anildash/dashtouch/helper/tests/test_webui.py

import http.client
import json
import pathlib
import threading
import time
import urllib.error
from types import SimpleNamespace
from unittest import mock

from dashtouch_helper import webui


CANNED_HEALTH = [
    {"id": "device", "label": "Device", "ok": True, "state": "ok",
     "detail": "Connected — firmware dt-0.1.0", "fix": "help-not-connected"},
    {"id": "password", "label": "Password", "ok": False, "state": "bad",
     "detail": "Not set up yet", "fix": "help-password"},
]


class FakeDaemon:
    def __init__(self):
        self.state = {"connected": True, "sensor": "ok", "fw": "dt-0.1.0",
                      "enroll_stage": "", "last_line": "", "cap": "200",
                      "slots_used": [1, 3], "last_match": None}
        self.sent = []
        self.events = []
        self._events_lock = threading.Lock()

    def send_command(self, line):
        self.sent.append(line)

    def log_event(self, direction, text):
        self.events.append({"t": time.time(), "dir": direction, "text": text})

    def health(self):
        return CANNED_HEALTH


def start():
    d = FakeDaemon()
    url = webui.start(d, port=0)  # 0 = ephemeral port for tests
    host, port = url.split("//")[1].split("/")[0].split(":")
    token = url.split("token=")[1]
    return d, host, int(port), token


def req(host, port, method, path, body=None, token=None):
    c = http.client.HTTPConnection(host, port, timeout=3)
    headers = {"Content-Type": "application/json"}
    if token:
        headers["X-DT-Token"] = token
    c.request(method, path, json.dumps(body) if body else None, headers)
    r = c.getresponse()
    return r.status, json.loads(r.read() or b"{}")


def test_status_needs_no_token():
    d, host, port, token = start()
    status, body = req(host, port, "GET", "/api/status")
    assert status == 200 and body["connected"] is True


def test_status_carries_slots_used():
    d, host, port, token = start()
    status, body = req(host, port, "GET", "/api/status")
    assert status == 200
    assert body["slots_used"] == [1, 3]


def test_status_carries_health_rows():
    d, host, port, token = start()
    status, body = req(host, port, "GET", "/api/status")
    assert status == 200
    assert body["health"] == CANNED_HEALTH


def test_enroll_without_token_rejected():
    d, host, port, token = start()
    status, _ = req(host, port, "POST", "/api/enroll", {"slot": 1, "label": "x"})
    assert status == 403
    assert d.sent == []


def test_enroll_with_token_sends_command_and_saves_label(tmp_path, monkeypatch):
    monkeypatch.setattr(webui, "LABELS_PATH", tmp_path / "labels.json")
    d, host, port, token = start()
    status, _ = req(host, port, "POST", "/api/enroll",
                    {"slot": 2, "label": "right index"}, token)
    assert status == 202
    assert d.sent == ["ENROLL 2"]
    # Label is stored in pending_label, not written yet
    assert d.pending_label == {"slot": 2, "label": "right index"}
    # Labels file should not exist
    assert not (tmp_path / "labels.json").exists()


def test_delete_with_token(tmp_path, monkeypatch):
    monkeypatch.setattr(webui, "LABELS_PATH", tmp_path / "labels.json")
    d, host, port, token = start()
    req(host, port, "POST", "/api/enroll", {"slot": 2, "label": "x"}, token)
    status, _ = req(host, port, "POST", "/api/delete", {"slot": 2}, token)
    assert status == 202
    assert d.sent == ["ENROLL 2", "DELETE 2"]


def test_malformed_body_returns_400():
    d, host, port, token = start()
    c = http.client.HTTPConnection(host, port, timeout=3)
    c.request("POST", "/api/enroll", "not json{{{", {"Content-Type": "application/json", "X-DT-Token": token})
    assert c.getresponse().status == 400
    assert d.sent == []


def test_non_object_json_body_returns_400():
    d, host, port, token = start()
    c = http.client.HTTPConnection(host, port, timeout=3)
    c.request("POST", "/api/enroll", "[1,2,3]", {"Content-Type": "application/json", "X-DT-Token": token})
    assert c.getresponse().status == 400
    assert d.sent == []


def test_start_persists_tokened_url(tmp_path, monkeypatch):
    monkeypatch.setattr(webui, "URL_PATH", tmp_path / "webui-url")
    d = FakeDaemon()
    url = webui.start(d, port=0)
    # Persisted link should be token-less (so it can't be leaked via the
    # filesystem), while the returned URL includes the session token.
    assert (tmp_path / "webui-url").read_text().strip() == url.split("?")[0]
    assert "token=" in url


def test_start_never_adopts_a_stored_token(tmp_path, monkeypatch):
    # The helper used to reuse any stored token of 16+ characters. That's how
    # a test fixture string, written into a real Keychain by an earlier
    # mocking gap, ended up being served as a live session token. Whatever is
    # in storage, a new run mints its own and overwrites it.
    monkeypatch.setattr(webui, "TOKEN_PATH", tmp_path / "token")
    from dashtouch_helper import keychain

    stale = "x" * 40
    keychain.set_session_token(stale)

    d = FakeDaemon()
    url = webui.start(d, port=0)
    token = url.split("token=")[1]

    assert token != stale
    assert len(token) >= 16
    # ...and the stale value is gone from storage, not just unused.
    assert keychain.get_session_token() == token


def test_start_persists_a_freshly_generated_token(tmp_path, monkeypatch):
    # Token persistence is Keychain-backed in production; tests use the fake
    # keychain that reads/writes webui.TOKEN_PATH. Asserting only that the
    # URL carries *a* token is not enough: a duplicated
    # `token_freshly_generated = token is None` block once left that always
    # False, so the token was never written to the Keychain at all and
    # `dashtouch pins` (which reads it back) broke, with the suite still green.
    monkeypatch.setattr(webui, "TOKEN_PATH", tmp_path / "token")
    from dashtouch_helper import keychain

    d = FakeDaemon()
    url = webui.start(d, port=0)
    token_content = url.split("token=")[1]
    assert len(token_content) >= 16
    assert keychain.get_session_token() == token_content


def test_start_with_token_path_as_directory(tmp_path, monkeypatch):
    monkeypatch.setattr(webui, "TOKEN_PATH", tmp_path / "token")
    # Create a directory where the token file should be
    (tmp_path / "token").mkdir()
    d = FakeDaemon()
    url = webui.start(d, port=0)
    # Should still work with an in-memory token despite the directory in the way
    assert "token=" in url


def test_start_with_invalid_utf8_token(tmp_path, monkeypatch):
    monkeypatch.setattr(webui, "TOKEN_PATH", tmp_path / "token")
    # Write invalid UTF-8 bytes to the token file
    (tmp_path / "token").write_bytes(b"\xff\xfe")
    d = FakeDaemon()
    url = webui.start(d, port=0)
    # The returned URL contains the one-time token used for this run.
    assert "token=" in url
    token_content = url.split("token=")[1]
    assert len(token_content) >= 16


def test_enroll_with_null_slot_returns_400():
    d, host, port, token = start()
    status, _ = req(host, port, "POST", "/api/enroll", {"slot": None, "label": "x"}, token)
    assert status == 400
    assert d.sent == []


def test_log_requires_token_then_returns_events():
    d, host, port, token = start()
    status, _ = req(host, port, "GET", "/api/log")
    assert status == 403
    d.log_event("device", "hello")
    status, body = req(host, port, "GET", "/api/log", token=token)
    assert status == 200
    assert any(e["text"] == "hello" for e in body["events"])


def test_rejected_post_appends_web_event():
    d, host, port, token = start()
    req(host, port, "POST", "/api/enroll", {"slot": 1, "label": "x"})  # no token
    status, body = req(host, port, "GET", "/api/log", token=token)
    assert status == 200
    assert any(e["text"] == "rejected: bad token" for e in body["events"])


def test_default_port_is_3274():
    """When no port argument is given, default is 3274 (or fallback if busy)."""
    d = FakeDaemon()
    url = webui.start(d)  # no port argument = use default
    # Extract port from URL
    actual_port = int(url.split(":")[2].split("/")[0])
    # Port should be 3274 unless it was busy (check daemon log for fallback message)
    if actual_port == 3274:
        # Normal case: port 3274 was available
        assert True
    else:
        # Fallback case: port 3274 was busy, check that we logged it
        assert any("was busy" in e.get("text", "") for e in d.events)


def test_dashtouch_port_env_override_ephemeral():
    """DASHTOUCH_PORT=0 env variable overrides default and uses ephemeral binding."""
    d = FakeDaemon()
    import os
    # Temporarily set env var
    old_val = os.environ.get("DASHTOUCH_PORT")
    try:
        os.environ["DASHTOUCH_PORT"] = "0"
        url = webui.start(d)  # no port argument, but env override = 0 (ephemeral)
        # Extract port from URL
        actual_port = int(url.split(":")[2].split("/")[0])
        # Should be ephemeral (non-zero, assigned by OS)
        assert actual_port > 0, "Ephemeral binding should assign a port > 0"
        assert actual_port != 3274, "With DASHTOUCH_PORT=0, should not use default port"
    finally:
        if old_val is None:
            os.environ.pop("DASHTOUCH_PORT", None)
        else:
            os.environ["DASHTOUCH_PORT"] = old_val


def test_api_status_carries_last_match():
    """Verify that /api/status includes last_match from daemon state."""
    d = FakeDaemon()
    d.state["last_match"] = {"slot": 5, "score": 150}
    host, port, token = start.__wrapped__(d, None, None) if hasattr(start, '__wrapped__') else (None, None, None)
    # Need to get host/port from actual start; use simpler approach
    url = webui.start(d, port=0)
    host, port = url.split("//")[1].split("/")[0].split(":")
    host = host.strip()
    port = int(port)
    token = url.split("token=")[1]

    status, body = req(host, port, "GET", "/api/status")
    assert status == 200
    assert body["last_match"] == {"slot": 5, "score": 150}


def test_enroll_stores_pending_label_not_labels_file(tmp_path, monkeypatch):
    """Enroll request stores pending_label but doesn't write labels.json."""
    from dashtouch_helper import webui
    monkeypatch.setattr(webui, "LABELS_PATH", tmp_path / "labels.json")
    d = FakeDaemon()
    url = webui.start(d, port=0)
    host, port = url.split("//")[1].split("/")[0].split(":")
    token = url.split("token=")[1]
    port = int(port)

    # Enroll a finger
    status, body = req(host, port, "POST", "/api/enroll",
                       {"slot": 5, "label": "right index"}, token=token)
    assert status == 202

    # Labels file should not exist yet
    assert not (tmp_path / "labels.json").exists()
    # Daemon should have pending_label
    assert d.pending_label == {"slot": 5, "label": "right index"}


def test_api_label_requires_token(tmp_path, monkeypatch):
    """POST /api/label without token returns 403."""
    from dashtouch_helper import webui
    monkeypatch.setattr(webui, "LABELS_PATH", tmp_path / "labels.json")
    d = FakeDaemon()
    url = webui.start(d, port=0)
    host, port = url.split("//")[1].split("/")[0].split(":")
    token = url.split("token=")[1]
    port = int(port)

    status, body = req(host, port, "POST", "/api/label",
                       {"slot": 3, "label": "middle"}, token=None)
    assert status == 403


def test_api_label_updates_labels(tmp_path, monkeypatch):
    """POST /api/label with token updates labels.json."""
    from dashtouch_helper import webui
    monkeypatch.setattr(webui, "LABELS_PATH", tmp_path / "labels.json")
    d = FakeDaemon()
    url = webui.start(d, port=0)
    host, port = url.split("//")[1].split("/")[0].split(":")
    token = url.split("token=")[1]
    port = int(port)

    status, body = req(host, port, "POST", "/api/label",
                       {"slot": 3, "label": "middle"}, token=token)
    assert status == 202

    # Check that label was written in object form with a fresh timestamp
    labels = json.loads((tmp_path / "labels.json").read_text())
    assert labels["3"]["label"] == "middle"
    assert labels["3"]["added"] > 0


def test_api_label_slot_out_of_range(tmp_path, monkeypatch):
    """POST /api/label with slot 0 or 201 returns 400."""
    from dashtouch_helper import webui
    monkeypatch.setattr(webui, "LABELS_PATH", tmp_path / "labels.json")
    d = FakeDaemon()
    url = webui.start(d, port=0)
    host, port = url.split("//")[1].split("/")[0].split(":")
    token = url.split("token=")[1]
    port = int(port)

    status, body = req(host, port, "POST", "/api/label",
                       {"slot": 0, "label": "invalid"}, token=token)
    assert status == 400

    status, body = req(host, port, "POST", "/api/label",
                       {"slot": 201, "label": "invalid"}, token=token)
    assert status == 400


def test_old_format_string_label_loads_and_is_readable(tmp_path, monkeypatch):
    """A bare slot->string entry (the pre-Task-7i format) is tolerated: the
    loader upgrades it to {"label": str, "added": 0.0} in memory without
    requiring the user's on-disk file to be migrated first."""
    from dashtouch_helper import webui
    monkeypatch.setattr(webui, "LABELS_PATH", tmp_path / "labels.json")
    (tmp_path / "labels.json").write_text(json.dumps({"3": "right index"}))
    d = FakeDaemon()
    d.state["slots_used"] = [3]
    url = webui.start(d, port=0)
    host, port = url.split("//")[1].split("/")[0].split(":")
    port = int(port)

    status, body = req(host, port, "GET", "/api/status")
    assert status == 200
    assert body["slots"]["3"] == {"label": "right index", "added": 0.0}


def test_rename_preserves_added_timestamp(tmp_path, monkeypatch):
    """Renaming an already-labeled slot keeps its original `added` value —
    only the label text changes."""
    from dashtouch_helper import webui
    monkeypatch.setattr(webui, "LABELS_PATH", tmp_path / "labels.json")
    webui.save_label(3, "right index")
    original = json.loads((tmp_path / "labels.json").read_text())["3"]["added"]

    d = FakeDaemon()
    url = webui.start(d, port=0)
    host, port = url.split("//")[1].split("/")[0].split(":")
    token = url.split("token=")[1]
    port = int(port)

    status, _ = req(host, port, "POST", "/api/label",
                    {"slot": 3, "label": "right index finger"}, token=token)
    assert status == 202
    labels = json.loads((tmp_path / "labels.json").read_text())
    assert labels["3"]["label"] == "right index finger"
    assert labels["3"]["added"] == original


def test_enrolled_but_unlabeled_slot_still_appears_in_status(tmp_path, monkeypatch):
    """A slot enrolled outside the page (e.g. over serial) has no
    labels.json entry at all, but must still show up via slots_used so the
    page can render it as an "Unnamed" tile."""
    from dashtouch_helper import webui
    monkeypatch.setattr(webui, "LABELS_PATH", tmp_path / "labels.json")
    webui.save_label(1, "thumb")
    d = FakeDaemon()
    d.state["slots_used"] = [1, 7]  # slot 7 has no label entry
    url = webui.start(d, port=0)
    host, port = url.split("//")[1].split("/")[0].split(":")
    port = int(port)

    status, body = req(host, port, "GET", "/api/status")
    assert status == 200
    assert body["slots_used"] == [1, 7]
    assert "7" not in body["slots"]
    assert body["slots"]["1"]["label"] == "thumb"


# -- update check: version comparison ---------------------------------------

def test_compare_versions_equal():
    assert webui.compare_versions("0.1.0", "0.1.0") == 0


def test_compare_versions_simple_greater_and_less():
    assert webui.compare_versions("0.2.0", "0.1.0") == 1
    assert webui.compare_versions("0.1.0", "0.2.0") == -1


def test_compare_versions_numeric_not_lexicographic():
    """0.10.0 > 0.9.0 as a real version comparison; plain string
    comparison would get this backwards ("0.10.0" < "0.9.0" lexically)."""
    assert webui.compare_versions("0.10.0", "0.9.0") == 1
    assert webui.compare_versions("0.9.0", "0.10.0") == -1


# -- update check: mocked network -------------------------------------------

class FakeResponse:
    def __init__(self, body: bytes):
        self._body = body

    def read(self):
        return self._body

    def __enter__(self):
        return self

    def __exit__(self, *a):
        return False


def test_check_update_finds_a_newer_version(monkeypatch):
    payload = json.dumps({
        "version": "9.9.9",
        "security": False,
        "headline": "Big new stuff.",
        "url": "https://github.com/anildash/dashtouch",
    }).encode()
    monkeypatch.setattr(webui.urllib.request, "urlopen", lambda *a, **k: FakeResponse(payload))
    result = webui.check_update(current_version="0.1.0")
    assert result == {
        "checked": True,
        "current": "0.1.0",
        "latest": "9.9.9",
        "update_available": True,
        "security": False,
        "headline": "Big new stuff.",
        "url": "https://github.com/anildash/dashtouch",
    }


def test_check_update_already_current(monkeypatch):
    payload = json.dumps({"version": "0.1.0", "security": False,
                           "headline": "", "url": ""}).encode()
    monkeypatch.setattr(webui.urllib.request, "urlopen", lambda *a, **k: FakeResponse(payload))
    result = webui.check_update(current_version="0.1.0")
    assert result["checked"] is True
    assert result["update_available"] is False


def test_check_update_rejects_non_http_url_scheme(monkeypatch):
    # version.json is remote content. Its "url" field is rendered as a link
    # on the token-bearing page, and the client's escapeHtml doesn't
    # constrain the scheme — a "javascript:" URL would survive it and
    # execute. The server must not hand a non-http(s) URL to the client.
    payload = json.dumps({
        "version": "9.9.9",
        "security": False,
        "headline": "",
        "url": "javascript:alert(document.cookie)",
    }).encode()
    monkeypatch.setattr(webui.urllib.request, "urlopen", lambda *a, **k: FakeResponse(payload))
    result = webui.check_update(current_version="0.1.0")
    assert result["checked"] is True
    assert result["url"] == ""


def test_check_update_security_flag_passed_through(monkeypatch):
    payload = json.dumps({"version": "0.2.0", "security": True,
                           "headline": "Fixes a thing.", "url": "https://x"}).encode()
    monkeypatch.setattr(webui.urllib.request, "urlopen", lambda *a, **k: FakeResponse(payload))
    result = webui.check_update(current_version="0.1.0")
    assert result["security"] is True


def test_check_update_network_failure_returns_checked_false(monkeypatch):
    def boom(*a, **k):
        raise urllib.error.URLError("no route to host")
    monkeypatch.setattr(webui.urllib.request, "urlopen", boom)
    result = webui.check_update(current_version="0.1.0")
    assert result["checked"] is False
    assert "error" in result and isinstance(result["error"], str)


def test_check_update_timeout_returns_checked_false(monkeypatch):
    def boom(*a, **k):
        raise TimeoutError("timed out")
    monkeypatch.setattr(webui.urllib.request, "urlopen", boom)
    result = webui.check_update(current_version="0.1.0")
    assert result["checked"] is False


def test_check_update_bad_json_returns_checked_false(monkeypatch):
    monkeypatch.setattr(webui.urllib.request, "urlopen", lambda *a, **k: FakeResponse(b"not json{{{"))
    result = webui.check_update(current_version="0.1.0")
    assert result["checked"] is False


def test_check_update_missing_version_key_returns_checked_false(monkeypatch):
    payload = json.dumps({"security": False}).encode()
    monkeypatch.setattr(webui.urllib.request, "urlopen", lambda *a, **k: FakeResponse(payload))
    result = webui.check_update(current_version="0.1.0")
    assert result["checked"] is False


def test_check_update_malformed_version_returns_checked_false(monkeypatch):
    payload = json.dumps({"version": "not-a-version"}).encode()
    monkeypatch.setattr(webui.urllib.request, "urlopen", lambda *a, **k: FakeResponse(payload))
    result = webui.check_update(current_version="0.1.0")
    assert result["checked"] is False


# -- /api/check-update endpoint ----------------------------------------------

def test_check_update_endpoint_requires_token(monkeypatch):
    d, host, port, token = start()
    status, body = req(host, port, "POST", "/api/check-update", {})
    assert status == 403
    assert getattr(d, "last_update_check", None) is None


def test_check_update_endpoint_success_never_hits_real_network(monkeypatch):
    payload = json.dumps({"version": "9.9.9", "security": False,
                           "headline": "Neat stuff.", "url": "https://x"}).encode()
    monkeypatch.setattr(webui.urllib.request, "urlopen", lambda *a, **k: FakeResponse(payload))
    d, host, port, token = start()
    status, body = req(host, port, "POST", "/api/check-update", {}, token=token)
    assert status == 200
    assert body["checked"] is True
    assert body["update_available"] is True
    # The daemon's stored result is what /api/status hands back so the page
    # can re-render without triggering another fetch.
    assert d.last_update_check == body


def test_check_update_endpoint_failure_is_still_http_200(monkeypatch):
    def boom(*a, **k):
        raise urllib.error.URLError("offline")
    monkeypatch.setattr(webui.urllib.request, "urlopen", boom)
    d, host, port, token = start()
    status, body = req(host, port, "POST", "/api/check-update", {}, token=token)
    assert status == 200
    assert body["checked"] is False
    assert "error" in body


def test_check_update_endpoint_logs_a_helper_event(monkeypatch):
    payload = json.dumps({"version": "0.1.0", "security": False,
                           "headline": "", "url": ""}).encode()
    monkeypatch.setattr(webui.urllib.request, "urlopen", lambda *a, **k: FakeResponse(payload))
    d, host, port, token = start()
    req(host, port, "POST", "/api/check-update", {}, token=token)
    assert any(e["dir"] == "helper" and "update check" in e["text"] for e in d.events)


def test_status_carries_last_update_check(monkeypatch):
    d, host, port, token = start()
    assert d  # sanity
    status, body = req(host, port, "GET", "/api/status")
    assert status == 200
    assert body["last_update_check"] is None


# -- version.json -------------------------------------------------------------

def test_version_json_shape_and_sync_with_helper_version():
    from dashtouch_helper import __version__
    version_json_path = pathlib.Path(__file__).parents[2] / "version.json"
    data = json.loads(version_json_path.read_text())
    assert set(["version", "security", "headline", "url"]).issubset(data.keys())
    assert isinstance(data["version"], str)
    assert isinstance(data["security"], bool)
    assert isinstance(data["headline"], str) and data["headline"]
    assert isinstance(data["url"], str) and data["url"].startswith("https://")
    # Kept in sync by hand; this test is the tripwire if they drift.
    assert data["version"] == __version__


# -- /api/settings ------------------------------------------------------------

def test_settings_requires_token():
    d, host, port, token = start()
    status, _ = req(host, port, "POST", "/api/settings", {"key": "idle_color", "value": 3})
    assert status == 403
    assert d.sent == []


def test_settings_idle_color_valid_sends_set_line():
    d, host, port, token = start()
    status, body = req(host, port, "POST", "/api/settings",
                       {"key": "idle_color", "value": 5}, token)
    assert status == 202
    assert d.sent == ["SET idle_color 5"]


def test_settings_idle_color_zero_is_valid():
    d, host, port, token = start()
    status, _ = req(host, port, "POST", "/api/settings",
                    {"key": "idle_color", "value": 0}, token)
    assert status == 202
    assert d.sent == ["SET idle_color 0"]


def test_settings_idle_color_out_of_range_high_rejected():
    d, host, port, token = start()
    status, _ = req(host, port, "POST", "/api/settings",
                    {"key": "idle_color", "value": 8}, token)
    assert status == 400
    assert d.sent == []


def test_settings_idle_color_out_of_range_negative_rejected():
    d, host, port, token = start()
    status, _ = req(host, port, "POST", "/api/settings",
                    {"key": "idle_color", "value": -1}, token)
    assert status == 400
    assert d.sent == []


def test_settings_idle_style_valid_sends_set_line():
    d, host, port, token = start()
    status, body = req(host, port, "POST", "/api/settings",
                       {"key": "idle_style", "value": 2}, token)
    assert status == 202
    assert d.sent == ["SET idle_style 2"]


def test_settings_idle_style_zero_rejected():
    d, host, port, token = start()
    status, _ = req(host, port, "POST", "/api/settings",
                    {"key": "idle_style", "value": 0}, token)
    assert status == 400
    assert d.sent == []


def test_settings_idle_style_three_rejected():
    d, host, port, token = start()
    status, _ = req(host, port, "POST", "/api/settings",
                    {"key": "idle_style", "value": 3}, token)
    assert status == 400
    assert d.sent == []


def test_settings_unknown_key_rejected():
    d, host, port, token = start()
    status, _ = req(host, port, "POST", "/api/settings",
                    {"key": "brightness", "value": 1}, token)
    assert status == 400
    assert d.sent == []


def test_settings_press_enter_coerces_true_variants():
    for value in (True, 1, "1"):
        d, host, port, token = start()
        status, _ = req(host, port, "POST", "/api/settings",
                        {"key": "press_enter", "value": value}, token)
        assert status == 202
        assert d.sent == ["SET press_enter 1"]


def test_settings_press_enter_coerces_false_variants():
    for value in (False, 0, "0"):
        d, host, port, token = start()
        status, _ = req(host, port, "POST", "/api/settings",
                        {"key": "press_enter", "value": value}, token)
        assert status == 202
        assert d.sent == ["SET press_enter 0"]


# -- Task 7n: fp_swap (device-stored sensor pin orientation) ----------------

def test_settings_fp_swap_coerces_true_variants():
    for value in (True, 1, "1"):
        d, host, port, token = start()
        status, _ = req(host, port, "POST", "/api/settings",
                        {"key": "fp_swap", "value": value}, token)
        assert status == 202
        assert d.sent == ["SET fp_swap 1"]


def test_settings_fp_swap_coerces_false_variants():
    for value in (False, 0, "0"):
        d, host, port, token = start()
        status, _ = req(host, port, "POST", "/api/settings",
                        {"key": "fp_swap", "value": value}, token)
        assert status == 202
        assert d.sent == ["SET fp_swap 0"]


def test_settings_fp_swap_requires_token():
    d, host, port, token = start()
    status, _ = req(host, port, "POST", "/api/settings", {"key": "fp_swap", "value": 1})
    assert status == 403


# -- Task 7r: a second helper must not steal the saved link -----------------

import socket


def _free_port():
    """A port nothing is listening on right now (best effort — small race
    window, same pattern port=0 binding relies on elsewhere in this file)."""
    s = socket.socket(socket.AF_INET, socket.SOCK_STREAM)
    s.bind(("127.0.0.1", 0))
    port = s.getsockname()[1]
    s.close()
    return port


def test_second_instance_leaves_link_pointing_at_live_first_instance(tmp_path, monkeypatch):
    """(a) A live-looking existing link on a different port: URL_PATH must
    stay untouched, and the second instance must still serve on its own
    (ephemeral) port rather than exiting."""
    d1 = FakeDaemon()
    url1 = webui.start(d1, port=0)
    # persisted link should be token-less; returned URL still includes token
    assert webui.URL_PATH.read_text().strip() == url1.split("?")[0]

    d2 = FakeDaemon()
    url2 = webui.start(d2, port=0)
    assert url2 != url1

    # The saved link still points at the first (live) instance (token-less).
    assert webui.URL_PATH.read_text().strip() == url1.split("?")[0]

    # The second instance is still alive and serving requests.
    host2, port2 = url2.split("//")[1].split("/")[0].split(":")
    status, body = req(host2, int(port2), "GET", "/api/status")
    assert status == 200

    assert any("Another Dashboard Touch helper is already running" in e["text"]
                for e in d2.events)


def test_stale_link_on_dead_port_is_overwritten(tmp_path, monkeypatch):
    """(b) An existing link naming a port nobody is listening on is stale;
    starting overwrites it as before."""
    dead_port = _free_port()  # nothing bound here
    webui.URL_PATH.parent.mkdir(parents=True, exist_ok=True)
    webui.URL_PATH.write_text(f"http://127.0.0.1:{dead_port}/?token=deadbeef\n")

    d = FakeDaemon()
    url = webui.start(d, port=0)
    assert webui.URL_PATH.read_text().strip() == url.split("?")[0]


def test_same_port_restart_overwrites_link_normally(tmp_path, monkeypatch):
    """(c) When the newly bound port matches the port already named in the
    link file (the ordinary restart-on-the-same-port case), no liveness
    probe is needed and the file is written as today."""
    free = _free_port()
    webui.URL_PATH.parent.mkdir(parents=True, exist_ok=True)
    webui.URL_PATH.write_text(f"http://127.0.0.1:{free}/?token=deadbeef\n")

    d = FakeDaemon()
    url = webui.start(d, port=free)
    assert f":{free}/" in url
    assert webui.URL_PATH.read_text().strip() == url.split("?")[0]


def test_corrupt_link_file_is_treated_as_stale(tmp_path, monkeypatch):
    """(d) An unreadable/corrupt existing link file doesn't crash start()
    and is simply overwritten."""
    webui.URL_PATH.parent.mkdir(parents=True, exist_ok=True)
    webui.URL_PATH.write_bytes(b"\xff\xfe not a url {{{")

    d = FakeDaemon()
    url = webui.start(d, port=0)
    assert webui.URL_PATH.read_text().strip() == url.split("?")[0]


def test_second_instance_does_not_overwrite_live_helpers_token(tmp_path, monkeypatch):
    """Part of the token protection: when a live helper elsewhere already
    owns the shared link, a second instance that had to generate a fresh
    token (no readable token file yet) must not persist that fresh token to
    TOKEN_PATH out from under the live helper."""
    d1 = FakeDaemon()
    url1 = webui.start(d1, port=0)
    # token1 may be in Keychain or in the persisted token file; accept either.
    # token1 is taken from the returned URL (canonical for programmatic callers)
    token1 = url1.split("token=")[1]
    assert f"token={token1}" in url1

    # Simulate a second instance starting with no readable token file, e.g.
    # a fresh machine state — but the live first helper's link is in place.
    corrupt_token_path = tmp_path / "token2"
    corrupt_token_path.write_bytes(b"\xff\xfe")
    monkeypatch.setattr(webui, "TOKEN_PATH", corrupt_token_path)

    d2 = FakeDaemon()
    url2 = webui.start(d2, port=0)
    assert url2 != url1
    # TOKEN_PATH (the second instance's) was never written, since it
    # deferred to the live first helper rather than claim the shared state.
    assert not corrupt_token_path.exists() or corrupt_token_path.read_bytes() == b"\xff\xfe"


# -- /api/pause ---------------------------------------------------------------
# Guards the "Name this finger" bug: the device must actually stop matching
# while a naming/renaming field is focused, not just have the helper
# silently withhold the password (that would show the yellow "can't reach
# your Mac" ring, which is a lie). See docs/protocol.md's PAUSE command.

def test_pause_requires_token():
    d, host, port, token = start()
    status, _ = req(host, port, "POST", "/api/pause", {"paused": True})
    assert status == 403
    assert d.sent == []


def test_pause_true_sends_pause_1():
    d, host, port, token = start()
    status, body = req(host, port, "POST", "/api/pause", {"paused": True}, token)
    assert status == 202
    assert body == {"ok": True}
    assert d.sent == ["PAUSE 1"]


def test_pause_false_sends_pause_0():
    d, host, port, token = start()
    status, _ = req(host, port, "POST", "/api/pause", {"paused": False}, token)
    assert status == 202
    assert d.sent == ["PAUSE 0"]


def test_pause_missing_field_rejected():
    d, host, port, token = start()
    status, _ = req(host, port, "POST", "/api/pause", {}, token)
    assert status == 400
    assert d.sent == []


def test_pause_non_boolean_value_rejected():
    for junk in (1, "true", None, "yes", 0):
        d, host, port, token = start()
        status, _ = req(host, port, "POST", "/api/pause", {"paused": junk}, token)
        assert status == 400
        assert d.sent == []


def test_pause_malformed_body_rejected():
    d, host, port, token = start()
    status, _ = req(host, port, "POST", "/api/pause", None, token)
    assert status == 400
    assert d.sent == []


# -- DNS rebinding: binding to 127.0.0.1 stops remote packets, not remote
# pages. A site that points a hostname it controls at 127.0.0.1 becomes
# same-origin in the browser's eyes, and same-origin is all it takes to read
# /api/token and then drive the mutating routes. The Host header is what
# tells the two apart. ----------------------------------------------------

def req_with_host(host, port, method, path, host_header, body=None, token=None):
    c = http.client.HTTPConnection(host, port, timeout=3)
    headers = {"Content-Type": "application/json", "Host": host_header}
    if token:
        headers["X-DT-Token"] = token
    c.request(method, path, json.dumps(body) if body else None, headers)
    r = c.getresponse()
    return r.status, json.loads(r.read() or b"{}")


def test_token_endpoint_rejects_rebound_host():
    d, host, port, token = start()
    status, body = req_with_host(host, port, "GET", "/api/token", "evil.example")
    assert status == 403
    assert body["error"] == "bad host"


def test_token_endpoint_rejects_rebound_host_with_matching_port():
    # The port lining up is not evidence of anything — a rebinding attacker
    # picks the port. Only the hostname distinguishes the cases.
    d, host, port, token = start()
    status, _ = req_with_host(host, port, "GET", "/api/token",
                              f"evil.example:{port}")
    assert status == 403


def test_mutating_route_rejects_rebound_host_even_with_a_valid_token():
    d, host, port, token = start()
    status, _ = req_with_host(host, port, "POST", "/api/enroll",
                              f"evil.example:{port}",
                              {"slot": 2, "label": "x"}, token)
    assert status == 403
    assert d.sent == []


def test_status_rejects_rebound_host():
    # /api/status needs no token, so the Host check is the only thing
    # keeping a rebound page from reading the device's state.
    d, host, port, token = start()
    status, _ = req_with_host(host, port, "GET", "/api/status", "evil.example")
    assert status == 403


def test_loopback_hosts_are_accepted():
    d, host, port, token = start()
    for host_header in (f"127.0.0.1:{port}", f"localhost:{port}",
                        f"LOCALHOST:{port}"):
        status, body = req_with_host(host, port, "GET", "/api/token",
                                     host_header)
        assert status == 200, host_header
        assert body["token"] == token
