anildash/dashtouch/firmware/dashtouch/secrets.example.h

#pragma once
// Copy to secrets.h (gitignored) — `dashtouch setup` does this for you.
// The 32 bytes must match the pairing key in your Mac's Keychain.
static const uint8_t PAIRING_KEY[32] = {
  0x00, 0x00, 0x00, 0x00, 0x00, 0x00, 0x00, 0x00,
  0x00, 0x00, 0x00, 0x00, 0x00, 0x00, 0x00, 0x00,
  0x00, 0x00, 0x00, 0x00, 0x00, 0x00, 0x00, 0x00,
  0x00, 0x00, 0x00, 0x00, 0x00, 0x00, 0x00, 0x00
};
