anildash/dashtouch/(commit log)

2026-08-04 Add hardware build design spec
    Documents microcontroller/sensor selection (QT Py ESP32-S3 + ZW101),
    the required firmware pin remap since GPIO 43/44/2 aren't broken out
    on the QT Py, and known README/firmware wiring discrepancies.
2026-08-04 Add cost/BOM comparison to hardware build spec
    Documents live pricing (Adafruit/Amazon/Apple/eBay) confirming the
    ~$24 electronics BOM against new ($149) and used (~$55-65) Touch ID
    keyboard prices, and the Adafruit sensor stock situation behind
    sticking with the non-Adafruit ZW101.
2026-08-10 Fix QT Py ESP32-S3 pin mapping and add fingerprint enrollment
    The keyboard firmware hardcoded UART/interrupt pins that don't match
    the QT Py ESP32-S3's actual header (GPIO43/44/2 aren't broken out on
    this board). Remap to the labeled TX/RX/A3 pins.
    No enrollment path existed anywhere in the repo - the firmware only
    matched against pre-existing sensor slots. Add ENROLL/DELETE serial
    commands implementing the standard AS608/ZW101 enroll sequence, plus
    tinytouch_enroll.py to drive it interactively.
    Also fix the helper's port auto-detection, which hard-failed when the
    connected board's USB serial number didn't match the original author's
    device, and correct the launchd plist's hardcoded paths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
2026-08-10 Document ZW111 pinout/wiring and add hardware build plan
    Records the ZW111's actual 6-pin layout (vs. the ZW101 spec) and the
    build's cable color convention, plus the step-by-step hardware build
    plan referenced from the spec.
2026-08-10 Reconcile docs with what's actually built and soldered
    - Interrupt pin is A3/GPIO8 (what's committed in firmware and
    soldered), not A0/GPIO18 from an earlier draft
    - Enrollment is via built-in ENROLL/DELETE serial commands
    (tinytouch_enroll.py), not a separate temporary sketch
    - ZW111 wiring now includes the 6th pin (V_SENSOR, separate from
    VCC) that earlier wiring steps omitted
    - Wire colors match the already-soldered QT Py header colors end to
    end instead of using a disconnected color scheme
    - Fix stale tinyTouch -> dashtouch path references
2026-08-11 Fix wrong LED command byte, add raw-byte debug logging for sensor bring-up
    setAura() sent instruction 0x3c for LED control; the correct
    AURALEDCONFIG code per both the Adafruit Fingerprint Sensor Library
    and a ZW111-specific reference driver is 0x35.
    Also add FP_RAW debug output (gated behind DEBUG_FP_RAW_ON_FAIL) that
    dumps raw bytes seen on the sensor UART whenever a command times out
    without a valid ACK - came out of diagnosing a dead-on-arrival ZW111
    unit where no baud rate or wiring configuration ever produced a valid
    0xEF01-framed response. Useful to leave in for the next sensor bring-up.
2026-08-11 Switch primary sensor to R503, document ZW111 debugging outcome
    The ZW111 unit received was exhaustively debugged (wiring, continuity,
    baud rates, TX/RX separation, protocol byte-for-byte comparison
    against two reference implementations) and never produced a valid
    response - concluded defective and replaced.
    R503 uses the same 0xEF01 protocol family and MX1.0-6P connector, so
    no firmware changes are needed, only a new pin-order table (its pin
    order differs from the ZW111's). Also updates the enclosure mounting
    notes for the R503's threaded M25 body instead of the ZW111's flush
    bezel, and the cost/BOM and build sequence accordingly.
2026-08-11 Document actual R503-compatible sensor ordered, with dimensions
    Confirms the ordered part (Amazon ASIN B08HM8QDVW, brand "Simlug") is
    an R503-pinout-compatible clone via its own product images, matching
    the genuine GROW R503 pin table exactly. Captures real physical
    dimensions for enclosure planning from the listing's dimensioned
    photo: 27.8mm front bezel, 19mm body height, 16.5mm threaded shank -
    flagging that the shank diameter differs from the genuine GROW
    datasheet's M25/23.5mm figures, so treat this listing's numbers as
    authoritative for this specific part and verify with calipers once
    in hand.
    Also notes this sensor ships with its own factory-crimped cable
    (unlike the ZW111, which req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
2026-08-11 Add R503 reference doc, fix two Aura LED bugs, update plan status
    Research pass ahead of the replacement sensor arriving, so bring-up is
    plug-in-and-go rather than re-research.
    Reference doc (docs/superpowers/references/r503-reference.md) collects
    canonical driver libraries, vendor datasheets, prior-art projects, and
    gotchas from other people's R503 builds. Most useful find is
    matpb/linux-fingerprint-r503, which is essentially tinyTouch for Linux
    and independently arrived at the same sensor->MCU->USB CDC->PAM
    architecture with the same MAC'd-link security model.
    Two real firmware bugs found by comparing against the R503Lib reference
    driver, both in Aura LED control:
    - Color constants were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
2026-08-11 Add sensor bring-up diagnostics, record final ZW111 diagnosis
    Promotes the two postmortem sketches out of the scratchpad into
    firmware/diagnostics/ so the next sensor bring-up has them:
    - fp_sweep: brute-forces the official Adafruit_Fingerprint library
    across 7 baud rates x both TX/RX orientations (software pin swap via
    the GPIO matrix, no rewiring, no finger needed). Using the canonical
    library rather than our own protocol code removes fpCommand() from
    the suspect list.
    - fp_led: drives the Aura LED and ignores all responses, isolating the
    host->sensor direction. OFF is the decisive state since a sensor
    never darkens its own ring spontaneously - and breathing blue is the
    fact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
    [fp_led.ino, fp_sweep.ino]
2026-08-11 Add enclosure design: under-desk false-drawer box
    Settles the enclosure concept: a false-drawer box mounted under the
    desktop beside the existing Jarvis handset, with the sensor centered on
    the front face where a drawer pull would sit, so it reads as furniture
    hardware rather than a device bolted to a desk.
    Captures the geometry (75-degree front face matched to the Jarvis
    handset, trapezoid sides so the top sits flush to the desk underside,
    dimensional ranges), and the mounting-hole approach.
    The hole is counterbored both sides because the sensor's ~12-15mm of
    usable thread is shorter than desktop-grade plywood. Notes that both
    counterbores increase thread protrusion - correcting an earlie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
2026-08-11 Enclosure: back counterbore only, flange proud on the front face
    The front face is not counterbored - the sensor's flange sits proud on
    the surface like real drawer hardware, which is the point of the
    false-drawer design. Only the back is relieved, to get enough thread
    through for the retaining nut.
    Simplifies the drilling sequence accordingly (mark center on the front
    since that position is what must look centered, pilot through, back
    counterbore, through-hole last).
    Also notes a useful tolerance: the 27.8mm flange covers a ~5.4mm ring
    around the 17mm hole, so minor tearout on the front face is hidden and
    that cut doesn't need to be perfect.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
2026-08-11 Fix misread sensor dimension: 16.5mm is barrel height, not diameter
    The listing's dimensioned photo labels 16.5mm on a vertical arrow - it
    is the height of the threaded barrel below the flange (19mm total minus
    the ~2.5mm flange), not the shank diameter. An earlier revision read it
    as a diameter and specified a ~17mm through-hole, which would have been
    badly undersized.
    The GROW R503 manual gives outer dia 28mm, inner dia 23.5mm, height
    19mm, thread M25 - and its flange and height figures match this unit
    exactly, so the barrel is ~23.5mm (about 15/16"), not 16.5mm.
    Knock-on corrections:
    - Through-hole is ~15/16", not 11/16".
    - More usable thread than assumed (16.5mm not ~13mm), so the back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
2026-08-12 Update enclosure design to the two-piece L, add cross-machine pickup notes
    Enclosure section was stale - it still described the false-drawer box
    with trapezoid sides. The design settled on something simpler: two
    rectangles of 3/4" plywood forming an L in section, with a horizontal
    top piece taking the mounting screws and an angled front piece carrying
    the sensor. No box, no back, no bottom.
    Records why the horizontal piece has to exist: a vertical screw through
    a 15-degree tilted face drifts ~13mm over a 50mm face, more than 3/4"
    ply is thick, so it breaks out the side. Screwing up through a
    horizontal piece is both drift-free and the method already proven on
    the left-side drawer.
    Adds the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
2026-08-13 Find board-side UART transmit fault; reopen both sensor verdicts
    The R503 arrived and was silent on all 14 sweep combinations, identically to
    the ZW111. A board-only loopback test -- one jumper between the TX and RX
    pads, no sensor attached -- found the cause:
    baud=57600 rx=16 tx=5 sent=8 received=256 bytes=00000000...
    baud=57600 rx=5 tx=16 sent=8 received=8 bytes=ef01a55a00ff427e
    The pad labeled TX (GPIO 5) cannot carry UART transmit. It receives fine and
    drives fine at DC, but a UART reading that line sees it held low. So no
    command this project ever sent reached either sensor, and neither could have
    replied. Both "defective sensor" diagnoses were made through a transmit pi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
2026-08-13 Get tinyTouch working end to end: 3.3VT was the missing wire
    Touch an enrolled finger and the real macOS password is typed:
    TOUCH -> MATCH 1 142 -> EV <nonce> <hmac> -> EV_SENT -> TYPED
    Two faults were stacked, and fixing only the first left the symptom
    unchanged:
    1. GPIO 5 cannot carry UART transmit on this board (already documented
    2026-08-12). Firmware now transmits on GPIO 16 and receives on GPIO 5,
    backwards relative to the silkscreen.
    2. Sensor pin 6 (3.3VT, white) was never connected. This is the one that
    mattered. Without it the module powers up, receives commands, and
    executes them -- the aura ring visibly obeys OFF and RED -- but cannot
    reply to anything. That is t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
    [fp_boot_listen.ino, fp_led.ino, fp_probe.ino]
2026-08-13 Add pre-refactor checkpoint documenting full project state
    Captures where the build stands now that the HID path works end to end,
    ahead of a planned refactor onto different base assumptions than the
    upstream tinyTouch fork.
    The organizing idea is the split between sections 4 and 5: durable
    hardware/protocol facts that survive any refactor (3.3VT is mandatory,
    GPIO 5 can't transmit, ReadSysPara as model ID, hand-rolled 0xEF01 works,
    DTR required for CDC) versus inherited tinyTouch design assumptions that
    are all revisable (HID password typing, macOS-only host daemon, Keychain,
    5-slot cap, red/blue pill split, Arduino toolchain).
    Also records the dead ends explicitly, several of which were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
2026-08-13 Add Dashboard Touch design spec
    The approved design for refactoring the tinyTouch fork into Dashboard
    Touch: HID-only ground-up rewrite (PIV tree deleted), arduino-cli firmware
    with silkscreen-default pins, Python helper as sole serial-port owner
    serving a localhost web UI for enrollment, the proven wire protocol
    re-implemented from a normative spec with test vectors, consumer-voice
    documentation throughout, and an in-place execution plan gated on an
    eight-item hardware parity checklist before any legacy deletion.
2026-08-13 Add fp_colors ring-palette survey; verify full palette on this unit
    New diagnostic loops all 7 aura colors and 4 animated modes in a fixed,
    self-describing sequence so clone rings can be surveyed by eye. This
    build's unit renders all 7 colors distinctly and animates all 4 modes,
    despite its listing advertising a 2-color ring.
    Also links the confirmed upstream tinyTouch URL in the design spec.
    [fp_colors.ino]
2026-08-13 Define the official LED language in the design spec
    Cyan for enroll-lift (purple stays idle-only), yellow for Mac-side
    problems, red exclusively for device-side problems, and an honest
    three-layer boot-failure signal: best-effort red on the ring, absence-of-
    purple as the documented diagnostic, and the QT Py's own NeoPixel as the
    narrator the sensor can't take down.
2026-08-13 Add Dashboard Touch rewrite implementation plan
    Ten tasks from protocol spec to legacy deletion: pinned test vectors
    shared between pytest and a firmware self-test, TDD on every host
    module, hardware verification steps at each firmware stage, and the
    eight-item parity gate before the deletion commit.
2026-08-13 Add Dashboard Touch firmware core: r503 driver, LED language, boots to READY
2026-08-13 Clamp ack checksum validation to captured bytes
2026-08-13 Wipe password buffer on failed GCM authentication
    [link.cpp]
2026-08-13 Add firmware state machine: match/type flow, enrollment, LED transitions
2026-08-13 Reset replay counter on new serial sessions; guard _ser against cross-thread races
    [daemon.py, test_daemon.py]
2026-08-13 Add localhost web UI: status, browser-driven enrollment, slot labels
2026-08-13 Redesign the web UI: live twin ring, truthful slot picker, help links
    [daemon.py, link.cpp, r503.cpp, r503.h, test_daemon.py, test_webui.py]
2026-08-13 Count pairing failures by typed error code, not message text
    [daemon.py, protocol.py, test_daemon.py]
2026-08-14 Change default port to 3274 (DASH on phone keypad) with env override and busy-port fallback
    - webui.start() default port 3274 with DASHTOUCH_PORT env override (tolerates invalid values)
    - try/except OSError wraps ThreadingHTTPServer bind; on failure, retry with port 0 (ephemeral)
    - Fallback logs "was busy — moved to ephemeral" to daemon and stdout (persisted webui-url carries real port)
    - Update all 8737 references to 3274 in test_cli.py
    - Add tests: default port 3274 or fallback detection, DASHTOUCH_PORT=0 ephemeral bind
    - README: one-line note about port 3274 in Set it up section
    - Suite: 56 passing tests
    [test_cli.py, test_webui.py, webui.py]
2026-08-14 Audit and link every line of user-facing copy
    Walked README, setup, CLI, web UI, and troubleshooting docs in user
    sequence. Wired in the binding product-link list (cable, sensor,
    enclosure, board alternatives) with the affiliate disclosure, added
    missing help-anchor cross-links, fixed three commands that were
    missing the working .venv/bin/dashtouch prefix, and linked the
    board-fault step to firmware/diagnostics/README.md.
    [cli.py]
2026-08-14 Add launch notes: landing page structure, blog material, shopping list
    Working notes gathered while the build is fresh. The shopping list carries
    the real affiliate links and honest framing on the untested cheaper board.
    The blog spine is the two-wrongly-condemned-sensors arc, whose moral is
    that a test which cannot fail correctly is worse than no test.
2026-08-14 Say which finger matched, not just that one did
    - daemon.py: record last matched slot/score in state["last_match"] on successful verification only
    - webui.py: /api/status already carries full state including last_match (no change needed)
    - app.js: when rendering TYPED (match) state, look up slot in labels dict and say "That's your {label}" or "That's slot {n}" if unlabeled
    - daemon tests: verify valid EV records last_match, tampered EV leaves it None, unconfigured daemon ignores EV
    - webui tests: verify /api/status carries last_match from FakeDaemon
    - Suite: 60 passing tests (56 + 4 new)
2026-08-14 Name fingers only when enrollment succeeds, and let them be renamed
    FIX 1 - commit labels only on success:
    - webui.py: /api/enroll stores pending_label in daemon instead of writing labels.json
    - daemon.py: ENROLL_OK writes pending_label if it matches the slot; ENROLL_FAIL clears it
    - webui.py: new save_label() and prune_labels() functions for label lifecycle
    - webui.py: new POST /api/label route for renaming fingers (token-gated, 1-200 range check)
    FIX 2 - cleanup of existing orphans:
    - daemon.py: INDEX_OK prunes labels for slots not in the bitmap, logs tidying event
    - Handles self-healing of phantom labels like slot 5 "still alive"
    FIX 3 - rename UI:
    - app.js: add Rename button to each fi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
    [daemon.py, test_daemon.py, test_webui.py, webui.py]
2026-08-14 Rebuild the finger list as Touch ID-style tiles, with names after enrollment
2026-08-14 Register the launch agent with the modern launchctl API, and verify it took
    The legacy launchctl load/unload commands silently no-op on newer macOS,
    leaving the helper unregistered while claiming success. This was the failure
    mode: the user saw "Installed" but the helper never started.
    FIX: use modern service-management API (bootstrap/bootout) with verification.
    - cmd_install_agent: bootout (tear down if present), bootstrap, then verify with
    launchctl print. Return error if verification fails (API accepted but not registered).
    - cmd_uninstall_agent: bootout, confirm it's gone with launchctl print.
    - On success, print how to uninstall later (matching the new uninstall-agent command).
    - Upd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
    [cli.py, test_cli.py]
2026-08-14 Stop the status poll from stealing focus while you're naming a finger
    The ~800ms refresh() poll was destroying and recreating the rename input
    element on every tick, causing focus loss and text disappearance mid-edit.
    FIX: Track which finger (if any) is being edited in editingSlot. Skip
    renderFingerPanel() while an edit is active, letting the input survive
    multiple polls undisturbed. The rest of the page (ring, checkup, device
    card, log) keeps updating normally.
    Also add keyboard support: Escape cancels the edit (clears editingSlot,
    restores tile), Enter saves. Belt-and-braces: check if activeElement is
    an input in the finger panel and skip rebuild even if editingSlot wasn't
    explicitly set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
2026-08-14 Add an update check you have to ask for
    Two small UI fixes plus the product's first and only outbound network
    call, gated entirely behind an explicit click:
    - Drop the redundant hairline above System Setup.
    - Normalize the three footer social icons to a shared 18x18 optical
    size (each path's scale/padding adjusted within the same viewBox,
    since matching viewBox attributes alone didn't make them look the
    same size).
    - POST /api/check-update (token-gated, like other mutating routes)
    fetches version.json from GitHub via stdlib urllib, compares versions
    as numeric tuples (so 0.10.0 > 0.9.0), and never crashes or 500s on
    failure. The browser never talks to the network directly. A sma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
    [daemon.py, test_webui.py, webui.py]
2026-08-14 Let the ring go dark, and let Return be optional
    Add device settings (idle ring color/style, press-Return) stored on the
    ESP32 in NVS via Preferences, so they're correct from power-on. New
    SETTINGS/SET serial commands, helper parsing + token-gated /api/settings,
    and a page Settings section with visual swatches, a collision warning for
    the five colors that double as status signals, and an old-firmware
    fallback.
    [config.h, daemon.py, dashtouch.ino, led.cpp, led.h, link.cpp, settings.cpp, settings.h]
2026-08-14 Drop the upgrade-path copy — there are no old installs to upgrade
2026-08-14 Store the sensor pin orientation on the device, not in a source edit
    fp_swap is a new NVS-backed setting (default false = config.h's
    silkscreen pins). SET fp_swap re-initializes the sensor UART and
    re-runs the handshake immediately, no reboot needed. `dashtouch pins`
    (--swap/--normal, deliberately not in the web UI) reads and sets it
    through the helper and reports whether the sensor came back.
    Only the sensor UART is affected by this setting — the USB CDC link
    to the Mac never changes — so a wrong value is always recoverable.
    config.h is left untouched; its uncommitted local swap will be
    reverted once the device holds the setting itself.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
    [cli.py, daemon.py, dashtouch.ino, link.cpp, link.h, settings.cpp, settings.h, test_cli.py]
2026-08-14 Mirror the ring's real resting color on the page
    The idle ring was hardcoded purple/steady, so it lied whenever a user
    picked a different resting color/style via settings.idle_color and
    settings.idle_style. Now the idle ring (and the legend's "Ready" swatch)
    render using the configured color/style, reusing the existing aura
    tokens and breathe animation. idle_color 0 (off) shows a dark ring with
    just a faint outline instead of nothing. Falls back to purple/steady
    when settings are still unknown from the device.
2026-08-14 Tuck settings behind a gear
    Settings sat open under Your fingers by default. Now it's a collapsible
    panel, closed on every load, toggled by a real button with a gear icon
    and the same disclosure caret Help and Under the hood use.
2026-08-14 Fix the live pin-swap re-init, tidy the setup rows, unify the version
    Root cause of the SET fp_swap live re-init bug: HardwareSerial::end()
    frees the UART driver but leaves the two physical pins latched to the
    old GPIO matrix routing. Since fp_swap reuses the same two pins with
    their TX/RX roles reversed, the pin that was just driving as TX can
    stay wired to the old peripheral output instead of going tri-state for
    its new RX role, so the fresh handshake times out even though the
    wiring is fine. initSensorUart() now gpio_reset_pin()s both sensor
    pins before reassigning them, with a short settle delay, so the swap
    works live in both directions without a reboot.
    Also: drop the redundant System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
    [config.h, daemon.py, dashtouch.ino]
2026-08-14 Report the sensor's real state after a pin swap
    A second live-reinit attempt (gpio_reset_pin before begin()) was flashed
    and tested: it still didn't restore a working sensor, and it introduced a
    false-positive handshake result — /api/status claimed "Sensor's talking"
    immediately after SET fp_swap even though the board's TX pad genuinely
    can't drive the line in that orientation. Tracing it: g_sensorOk was in
    fact being reassigned from the live handshake (no discard bug there), but
    the live handshake itself isn't trustworthy right after a runtime pin
    remap on this chip — two different re-init strategies both failed on real
    hardware, which means an in-place UART re-init isn't achievable her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
    [cli.py, daemon.py, dashtouch.ino, link.cpp, link.h, test_cli.py, test_daemon.py]
2026-08-14 Fix the ring rendering dark, and capture it for the README
    Setting a CSS custom property to a var() reference and consuming it from
    a stylesheet did not resolve, so the idle ring lost its color while the
    legend dot — which sets a direct property — kept working. Resolve the
    token to a literal value before assigning it.
2026-08-14 Add the hero screenshot and a photo of the build
    The device photo is stripped of EXIF — the original carried GPS
    coordinates and camera metadata that would have been published with it —
    and resized from 2.1MB to 574KB. Captioned as a work in progress, since
    the sensor isn't mounted into the desk yet.
2026-08-14 Delete the legacy tinyTouch trees: Dashboard Touch stands on its own
    All eight parity-gate items were verified on real hardware:
    1. Fresh flash boots to a steady purple ring, no idle flicker
    2. PING/PONG and STATUS report the protocol and firmware versions
    3. A finger enrolled entirely through the browser
    4. That finger types the real password
    5. An unknown finger is refused and types nothing
    6. Unplug/replug recovers with no restart
    7. The launch agent runs it with no terminal open
    8. ./setup completes from scratch on a rebuilt venv
    Removed: the tinyTouch HID firmware, the untouched PIV/CCID smartcard
    tree, the old macOS helper, and upstream's case STLs for a different
    boa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
    [case_bottom.stl, case_top.stl]
2026-08-14 Close the findings from the pre-publication security review
    Fixes all three criticals: secrets no longer hit argv when writing to the
    Keychain (piped over stdin instead), the tokened web UI URL no longer
    lands in launchd's shared /tmp log (bare origin on non-tty stdout, full
    link only in ~/.dashtouch/webui-url; logs moved to ~/Library/Logs/dashtouch),
    and a corrupt pairing-key Keychain entry now raises KeychainError instead
    of crash-looping the daemon under launchd's KeepAlive.
    Also: allowlist http(s) for the remotely-fetched update link (both server
    and client side), broaden the daemon's per-line exception handling so a
    bug in handle_line can't kill the process, stop `./setup` from clobber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
    [cli.py, daemon.py, keychain.py, test_cli.py, test_daemon.py, test_keychain.py, test_webui.py, webui.py]
2026-08-14 Print the helper's link when dashtouch is run with no command
    Bare `dashtouch` now returns the tokened web UI address on stdout, so it
    pipes (`open $(dashtouch)`), with the 'treat this like a password' note
    on stderr only when a person is watching. A missing or unreadable link
    file explains how to start the helper rather than raising.
    [cli.py, test_cli.py]
2026-08-14 Don't let a second helper steal the saved link
    A second helper landing on the busy-port fallback used to overwrite
    webui-url and, when unwritten, token with its own short-lived
    ephemeral instance — stranding the real helper (the one holding the
    fingerprint sensor) behind a dead link once the second process exited.
    webui.start() now probes the existing link's /api/status before
    overwriting it. If another helper answers there, the link and token
    files are left alone and this instance just keeps serving on its own
    port. A stale link (nothing answering) is still overwritten as
    before. The busy-port log/console message now says plainly that
    another instance is probably already running.
    Co-Aut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
    [test_webui.py, webui.py]
2026-08-14 Say plainly where the one outbound request goes
    The update button is the only thing here that reaches the internet, so
    it says so: on the button itself, on the line reporting a result, and in
    a Help entry explaining what gets fetched, what doesn't go with it, and
    why checking occasionally matters on a device that types your password.
2026-08-14 Pause the sensor while you're naming a finger
    The "Name this finger" field appears right after a touch, so a stray
    touch while it's focused could match and type the real password into
    the name field -- which then gets saved to labels.json in plaintext.
    Add a PAUSE serial command: the firmware skips the whole match scan
    while paused (no GenImg poll, no ring change, no EV), but enrollment
    and other serial commands keep working. Pause state is RAM-only, never
    persisted, and auto-resumes after 90s with no refresh so a crashed
    helper or closed tab can never leave the sensor permanently deaf.
    The helper exposes POST /api/pause (token-gated) and resyncs paused
    state from STATUS/PAUSE_OK; it also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
    [daemon.py, dashtouch.ino, link.cpp, link.h, test_daemon.py, test_webui.py, webui.py]
2026-08-14 Stop overstating how long the sensor debugging took
    The build ran Aug 3-14; 'two weeks' and 'believed for weeks' overstated
    it. The point was always that a bad metric survived repeated scrutiny,
    not that it survived a long time.
2026-08-14 Make the pause actually expire, and say so when it does
    Hardware testing found the 90s auto-resume never fired, and even when
    it would, nobody would find out: the helper only learns paused from a
    PAUSE_OK reply or a STATUS query, and it does neither on a timer.
    Decouple the auto-resume check from every gate that could starve it.
    linkTickPause() now runs unconditionally at the top of loop(), before
    the sensor-health gate, the poll throttle, and the pause branch itself
    -- none of them can skip it anymore, whatever combination caused the
    original miss. linkIsPaused() goes back to being a plain read (used by
    STATUS and the scan gate) with no side effects of its own.
    When the deadline fires, th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
    [dashtouch.ino, link.cpp, link.h, test_daemon.py]
2026-08-15 Write in the first person, and note the wireless idea
    The parts table and notes referred to me in the third person; this is my
    project, so they say 'I' now. Also answers the obvious question about the
    board's radios: possible in theory over Bluetooth, unexplored in practice.
2026-08-15 Prune the prehistory; point forward instead
    Removes docs/history, the rewrite spec and plan, and the internal copy
    audit, plus the war-story framing in the README and diagnostics guide.
    The debugging that got here isn't what a builder needs — how it works and
    how to improve it is. Credits now invite contributions; the wiring guide
    explains the white wire's symptom without the body count.
    All of it stays in git history.
2026-08-15 Move the launch notes out of the repo
    Blog framing, affiliate strategy and open questions to myself — working
    material, not project documentation, and not something to publish when
    the repo goes public.
2026-08-15 Rewrite the README in my own voice
    Restructures around how it works, what to buy, how to wire it, and what
    to do once it's running, with a future-directions note and an open
    invitation to contribute.
2026-08-15 Warn about the white wire again, in my own words
2026-08-17 Note the Keyboard Setup Assistant popup in the setup steps
    macOS opens Keyboard Setup Assistant the first time the board is plugged in
    after it's wired and flashed, because it enumerates as a USB keyboard. Tell
    people to click Quit, and that it's a good sign rather than a problem, so it
    doesn't read as a failed step. Also note it returns on a different USB port.
2026-08-17 Stop the helper around flashing instead of failing on a busy port
    `dashtouch pairing` and `dashtouch setup` offered to flash while the helper
    still had the serial port open, so the upload died with "Resource busy" —
    and because the launch agent sets KeepAlive, killing it just brought it
    back. The advice printed on failure pointed at arduino-cli commands that
    fail for the identical reason, so there was no way out from inside the tool.
    find_and_flash now stops the launch agent, waits for the port to actually
    come free (bootout returns before the process exits), flashes, and restores
    the agent on both the success and failure paths.
    Two things it can't fix, so it explains them instead:
    - A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
    [cli.py, test_cli.py]
2026-08-17 Keep security from prompting for the key it was handed
    `security add-generic-password -w` reads through readpassphrase(), which
    prefers /dev/tty over stdin whenever a controlling terminal exists. Under
    launchd and in tests there is no TTY, so the piped value was used and this
    looked correct. Run interactively — which is the only way `dashtouch setup`
    and `dashtouch pairing` are ever run — and security prompted the operator
    instead, stored their keystrokes, and discarded the generated key.
    It fails silently and late: secrets.h gets the real key, the Keychain gets
    whatever was typed, and the first symptom is the Checkup's Pairing row going
    red with nothing pointing back at the write. Foun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
    [daemon.py, keychain.py, test_daemon.py, test_keychain.py]
2026-08-17 security: remove token from URL, serve token via /api/token, add CSP/Referrer headers, update client and CLI
    Publish token-less localhost URL so session tokens aren't leaked via the address bar or Referer; add GET /api/token for the same-origin page to fetch the token; add CSP, X-Frame-Options, Referrer-Policy and X-Content-Type-Options headers on responses; update web client to fetch token and adjust CLI messaging.\n\nCo-authored-by: Copilot <223556219+Copilot@users.noreply.github.com>
    [cli.py, webui.py]
2026-08-17 ci: add diagnostics and install from requirements.txt to stabilize CI
    Print Python and workspace info for easier debugging and use requirements.txt for pip installs so cache key is stable.\n\nCo-authored-by: Copilot <223556219+Copilot@users.noreply.github.com>
2026-08-17 fix: restore token persistence, repair the web UI token race, block rebinding
    Three fixes from reviewing the last pass; the first two were invisible to
    the test suite.
    1. webui.start() had a duplicated `token_freshly_generated = token is None`.
    The second copy ran after the token was assigned, so the flag was always
    False and keychain.set_session_token() was never reached: the token was
    never stored, every restart minted a new one, and `dashtouch pins` — which
    reads it back via keychain.get_session_token() — failed with "Session
    token unavailable in Keychain."
    test_start_creates_token_file had been weakened in the same pass to assert
    only that the URL carried a token, which is why this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
    [test_webui.py, webui.py]
2026-08-17 docs: make the contributor setup work, and correct the secrets.h story
    CONTRIBUTING.md's instructions failed on a fresh clone: they installed
    pytest/pyserial/cryptography and then ran `cd helper && pytest -q`, with
    nothing putting helper/ on the import path, so every test file died with
    ModuleNotFoundError. `./setup` does `pip install -e helper`; the doc never
    mentioned it. Verified both ways in a clean venv. CI papered over the same
    gap with PYTHONPATH=.; it now installs the way the docs say to, so the
    documented path is the one actually under test. Also drops the leftover
    CI debugging steps and the trailing chatbot copy at the end of the doc.
    requirements.txt gains upper bounds and a note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
    [cli.py]
2026-08-17 docs: credit tinyTouch and Zimeng Xiong at the top of the README
    The credit was only at the bottom, under a heading most people never
    scroll to. Dashboard Touch is a refactoring of Zimeng Xiong's tinyTouch,
    which defined the whole approach — that belongs where people actually see
    it. The fuller credit stays where it was.
    Also fixes the "flashing by hand" instructions, which no longer worked:
    a successful flash deletes firmware/dashtouch/secrets.h, so a bare
    arduino-cli compile stops with "secrets.h: No such file or directory".
2026-08-17 security: mint a fresh session token per run, and stop tests reaching the Keychain
    A session token found in the wild turned out to be "seededtoken12345678" —
    a fixture constant from test_webui.py, sitting in a real login Keychain and
    being served by a live helper.
    It got there because the test that seeds a token was written one commit
    before the mocking that makes that safe (2ce770c, fixed in 02e0a8a). In
    that window it wrote straight through to the developer's Keychain. Nothing
    failed and nothing was logged. It only surfaced once the token-reuse path
    started working, at which point a helper adopted the value and served it.
    Three changes:
    Tokens are now minted fresh on every start and n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
    [test_daemon.py, test_webui.py, webui.py]
2026-09-25 serial_link: list usbmodem ports with a name and a stable identity
    find_port() returns a bare /dev path and gives up when there's more than
    one. To let someone choose between boards, each port needs a name a person
    recognizes and an identity that survives a reset renaming its /dev node.
    usb_ports() returns both, for the same /dev/cu.usbmodem* ports find_port()
    considers. Nothing uses it yet.
    [serial_link.py, test_serial_link.py]
2026-09-25 fix: ask which board to flash when several are plugged in
    With more than one USB serial device attached, flashing gave up: setup
    printed "Heads up: several boards found" and then "no board found", which
    isn't true and leaves no way forward.
    Before it's flashed, a dashtouch is just some board, so nothing can tell it
    apart from the others. The person has to choose. find_and_flash now lists
    the ports by name and asks which one to flash:
    - The board the helper already has open is the default, so a reflash is
    one keypress. Otherwise Enter skips flashing.
    - A bad answer asks again; running out of input skips.
    - A single device keeps today's yes/no prompt, now showing its name.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
    [cli.py, test_cli.py]
2026-09-25 fix: find the board again by identity after the helper lets go of it
    Releasing the port drops DTR, which can reset the board onto a new /dev
    node, so find_and_flash looks the port up again before uploading. It did
    that with find_port(), which gives up when more than one usbmodem port is
    present, and the flash then went to the stale name.
    Match the chosen board's USB identity instead, which works however many
    other boards are plugged in.
    [cli.py, test_cli.py]
2026-09-25 feat: add --port to setup and pairing
    For scripts, or anyone who'd rather name the board than be asked:
    `--port <device>` skips the question and flashes that port.
    [cli.py, test_cli.py]
2026-09-25 docs: don't pick the first port in the README's hand-flash command
    `arduino-cli board list | grep … | head -1` flashes whichever usbmodem
    port happens to be listed first. With another board plugged in, that can
    overwrite its firmware. Have the reader find their board's port and say
    why it matters.
2026-09-25 fix: don't crash-loop when more than one board is plugged in
    find_port() raises AmbiguousPortError when it sees several usbmodem ports,
    and run_forever called it outside any handler. Under launchd's KeepAlive
    that's a crash-loop: the helper exits, restarts ten seconds later, finds
    the same ports, and exits again, until someone unplugs a board. I hit this
    with a second ESP32-S3 board on the same hub; the log showed 13 crashes
    before I unplugged it.
    Treat it like any other absent board instead: keep looking every second,
    and connect as soon as there's one. Say why once per episode rather than
    once per retry, in the log and in the Checkup's Device row ("More than one
    board is plugged in"), so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
    [daemon.py, test_daemon.py]
2026-10-04 fix: compile without Rosetta, and stop tests deleting the real secrets.h
    arduino-cli's bundled ctags is x86-only, so every compile died with "Bad
    CPU type in executable" on an Apple Silicon Mac without Rosetta. ctags only
    generates prototypes for .ino files and dashtouch.ino defines everything
    before use, so point just the flash compile at an empty ctags when x86
    binaries can't run. The shared ~/Library/Arduino15 install is untouched.
    The find_and_flash tests also never redirected SECRETS_PATH, so a mocked
    successful flash erased the real firmware/dashtouch/secrets.h. They now use
    a temp path.
    [cli.py, test_cli.py]
2026-10-04 feat: let run and install-agent pin the helper to one serial port
    With other USB serial devices plugged in, the helper saw several
    /dev/cu.usbmodem* ports and refused to pick one. `dashtouch run --port`
    and `dashtouch install-agent --port` now pin it; the launch agent gets
    the port as DASHTOUCH_SERIAL_PORT since it can't take arguments. A pinned
    port that isn't present is waited on quietly instead of logged every second.
2026-10-04 docs: explain --port for run, install-agent, setup and pairing
    Add a README section for builders with other USB serial devices plugged in,
    and say which commands choose the board to flash versus which tell the
    running helper which board to use.
